inokron-doo/OA-HWcomponents/docs/SFS_Node_Hardware_Documentation_v0.1.docx

# SFS LoRa Sensor Network Node — Open Hardware Documentation

## 1. Hardware Identification

Hardware Title: SFS LoRa Sensor Network Node
Short Description: Open-source dual-role IoT node for feed level and microclimate monitoring in livestock barns. Configurable as sensor node or LoRa concentrator via firmware.
Keywords/Tags: feed monitoring, LoRa, IoT, livestock, digital agriculture, open hardware, OpenAgri
Author(s)/Designer(s): Inokron d.o.o. Hardware Team
Organization: Inokron d. o. o.
Contact Email: info@inokron.com
Repository URL: https://github.com/inokron-doo/OA-HWcomponents
Version: v0.1
Release Date: 2026-06-17

## 2. Purpose and Scope

The SFS LoRa Sensor Network Node is designed for continuous, automated monitoring of feed levels in livestock feeding troughs and measurement of ambient microclimate (temperature and humidity) within agricultural barn environments. The hardware provides the sensing infrastructure for the SmartFeed Feed Monitoring System (SFS), developed under the OpenAgri EU project (SIP13 grant).

## 3. System Overview

The SFS sensor network consists of multiple sensor nodes and one concentrator node per installation, arranged in a LoRa star topology. Sensor nodes are mounted above livestock feeding troughs; the concentrator and edge device are typically located in the farm office or other space with internet connection.

The following external system components are required for a complete installation but are outside the scope of this hardware document:

Component | Purpose
Raspberry Pi 4B | Edge processing device — runs Node-RED data pipeline and local data storage
USB-to-TTL serial adapter (CH340) | Connects concentrator UART output to Raspberry Pi
Huawei E8372 GSM modem | SMS alert delivery, independent of internet connectivity
Network switch and SIM card | Farm network connectivity and remote telemetry
Optional local display | Local operator dashboard (e.g. tablet or Raspberry Pi Touch Display)

## 4. System Architecture

Star topology: one concentrator, multiple sensor nodes per installation.

A single PCB design serves both roles. The hardware is identical for sensor nodes and concentrator nodes; the role is determined solely by the firmware loaded onto the device. This simplifies manufacturing, spares, and field replacement.

Sensor node: samples up to four UART distance sensors and one temperature/humidity sensor, applies on-device filtering, and transmits readings to the concentrator over LoRa.

Concentrator node: receives and validates LoRa packets from all sensor nodes and outputs decoded readings as an ASCII serial stream to the edge device via UART.

Data flow: distance sensors + climate sensor → sensor node → LoRa → concentrator → edge device (UART serial)

Because the hardware is role-agnostic, alternative topologies are achievable through firmware changes alone — for example, deploying multiple concentrators as relay bridges to extend range across a large farm, or introducing a mesh configuration for higher node density. No hardware modifications are required.

## 5. Functional Requirements

Sensor node: Measure feed level via up to four UART distance sensors; measure ambient temperature and humidity; apply initial filtering on-device; transmit readings over LoRa; auto-detect connected sensors; indicate operating status via onboard LEDs.

Concentrator node: Receive and CRC-validate LoRa packets from sensor nodes; output decoded readings as an ASCII serial stream over UART to the edge device; indicate operating status via onboard LEDs.

## 6. Non-Functional Requirements

Environmental: PCB operating temperature: −40°C to +80°C; installed system operating temperature subject to connected sensor specifications (SEN0648 operating range: -10 to +60). Not formally IP rated; enclosure design provides physical dust and splash resistance

Electrical: Mains input: 100–240V AC via HLK-5M05 module; PCB input: 5V DC.

Regulatory: LoRa 868 MHz operation subject to EU regulations.

System: Maximum sensor nodes per concentrator: 32; expected lifetime: >5 years.

## 7. Electronics Design

Schematics description: Schematics designed in Altium Designer (editable source files planned for release at the end of June 2026)
PCB layout description: Two-layer FR4 PCB, manufactured by JLCPCB. Gerber fabrication files are provided in the repository.
Main components: STM32F051K8T7 MCU, LR02 LoRa module, Sensirion SHT85 temperature and humidity sensor.
Electrical characteristics: PCB input 5V DC, 3.3V logic; mains (100–240V AC) handled by the self-contained HLK-5M05 module.

## 8. Mechanical Design

CAD files description:
Materials:
Dimensions and tolerances:
Enclosure design:

## 9. Bill of Materials (BOM)

The main components are:

STM32F051K8T7 MCU – 1 pc;

LR02 LoRa module (868 MHz) – 1 pc;

SHT85 temperature and humidity sensor – 1 pc (DHT22 supported as lower-cost alternative);

SEN0524 / SEN0648 distance sensors – up to 4 per node;

The full Bill of Materials (CSV) is provided in the project repository (electronics/bom/BOM_SFS_Node_v0.1.csv), with manufacturer part numbers, packages, quantities and supplier references (Farnell part numbers).

## 10. Firmware/Software (If Applicable)

Two firmware variants are provided for the same PCB hardware, determining the node’s role in the network:

• Sensor node firmware

• Concentrator node firmware

Both firmware variants are open-source. Full details (repository URLs, toolchain, build instructions, and communication protocol specification) are provided in the separate Open Software documentations.

## 11. Manufacturing and Fabrication

PCB fabricated using standard FR-4;
Gerber files provided;
Enclosure produced via FDM 3D printing.

## 12. Assembly Instructions

PCB: Solder all SMD components, then through-hole components (terminal blocks, pin headers, reset button).

Node enclosure: Mount HLK-5M05 power module, PCB and other components inside the housing. Connect PCB via terminal blocks. Route sensor cables through the enclosure openings. Connect one sensor directly into the integrated sensor slot on the enclosure.

Installation: Both the node enclosure and the additional sensor mounts clamp onto standard construction pipe using a screw-tightened clamp. Slide onto the pipe, aim the sensor vertically downward into the trough, then tighten the screw. The mount can be rotated around the pipe before tightening to fine-tune the sensor angle. Mount approximately 1.5–2m above the trough floor, with additional sensor mounts spaced at least 0.5m apart along the trough.

## 13. Calibration and Testing

Distance sensors configured to 115200 baud via serial command before installation. Empty and full trough heights set per sensor in the edge device configuration interface. Functional test via serial console on the concentrator output; LoRa connectivity verified by confirming all node IDs appear in the serial stream.

## 14. Performance Specifications

Distance sensing (SEN0648): sensor accuracy ±3cm per reading (datasheet); system-level accuracy expected better due to multi-second aggregation, filtering and multi-sensor deployment; refresh rate 100Hz; UART interface.

## 15. Safety and Compliance

PCB operates at 5V DC / 3.3V logic; mains voltage (100–240V AC) is handled by the self-contained HLK-5M05 module mounted separately in the enclosure. Components sourced from Farnell are RoHS-compliant; AliExpress-sourced components are unverified. LoRa 868 MHz operation is subject to local laws. CE marking not assessed.

## 16. Licensing and Usage Rights

Chosen open hardware license: CERN OHL-S v2.0;
Attribution required;
Commercial use allowed under share-alike conditions.

## 17. Reproducibility and Validation

Files provided in the v0.1 repository: schematic PDF, Gerber fabrication files, the full BOM (CSV), and the node enclosure STL (mechanical/SFS_Node_Enclosure_v0.1.stl). The editable schematic/PCB source files (Altium project) and the sensor-mount STL are pending and will be added in a later update (source files after June 2026). PCB is reproducible via any standard 2-layer FR4 fabrication service; the enclosure is printable on any FDM printer. Validated through field deployment at Novak farm, Kranj, Slovenia (4 sensor nodes, 1 concentrator) under OpenAgri SIP13.

## 18. Versioning and Changelog

Hardware versions tracked by PCB silkscreen marking and repository tags.

v0.1 (2026-06-17) - initial release; deployed at Novak farm, Kranj, Slovenia.

## 19. Known Limitations

Enclosure is not IP rated; not suitable for direct water exposure. Feed level readings can be noisy in deployments with a low number of sensors per trough location; a minimum of 3 sensors per location is recommended – with sensors not placed too close together. Temperature readings may degrade if the enclosure is exposed to direct sunlight; shaded installation is recommended.

## 20. Citation and Acknowledgements

Citation: Inokron d.o.o. (2026). SFS LoRa Sensor Network Node v0.1. OpenAgri EU project, SIP13. https://github.com/inokron-doo/OA-HWcomponents.

Funding: developed under the OpenAgri project, SIP13 , funded by the European Union.

## 21. Contact and Support

Maintainer name: Inokron d.o.o. Hardware Team
Institution: Inokron d.o.o., Kranj, Slovenia
Support email/Issue tracker: info@inokron.com
