inokron-doo/OA-HWcomponents/mechanical/SFS_Node_Enclosure_v0.1.stl

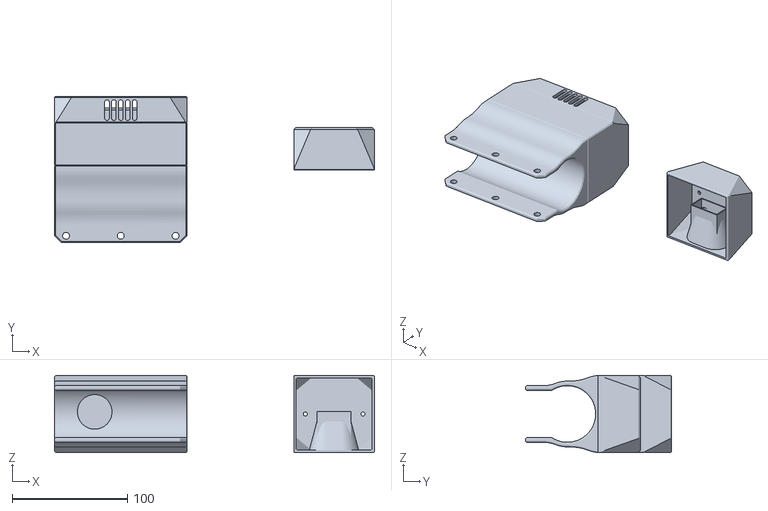
[picture p1: CAD file, 2026-07-06]
mechanical/SFS_Node_Enclosure_v0.1.stl
277.5 x 127.0 x 67.0
