inokron-doo/OA-HWcomponents/electronics/schematic/Lora_SensorNetworkNode_V0_1.1.pdf

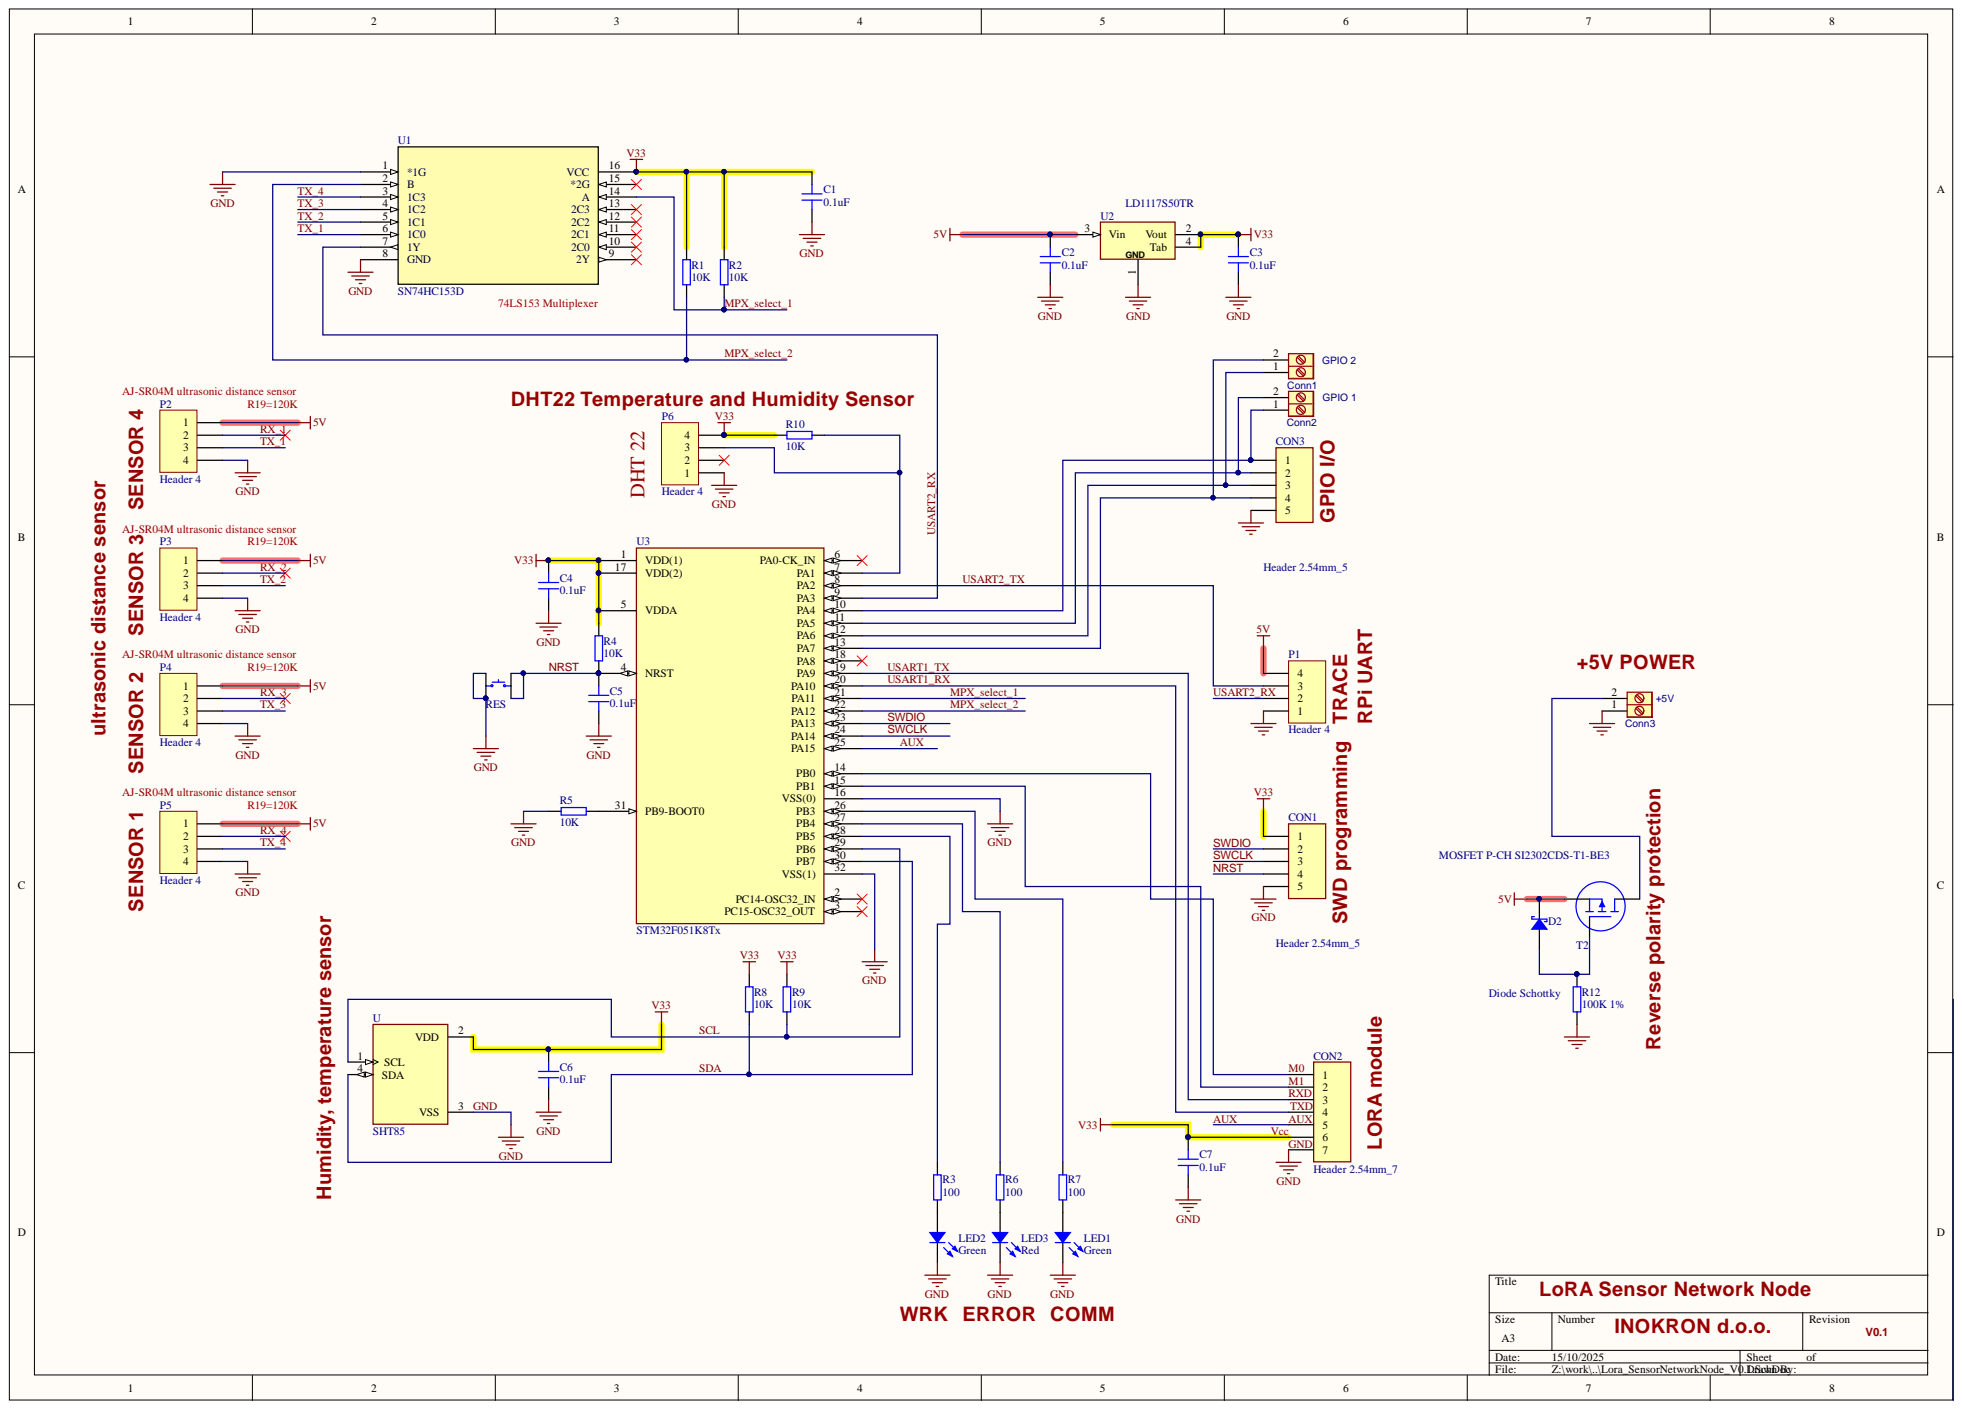
[picture p2: page 1]

MPX_select_2

AJ-SR04M ultrasonic distance sensor

DHT22 Temperature and Humidity Sensor

TXD

AUX

Vcc

Title
LoRA Sensor Network Node

# Board St
