inokron-doo/OA-HWcomponents/(list of files, drawings)

Other design files:
electronics/altium/Lora_SensorNetworkNode_V0.1.PcbDoc
electronics/altium/Lora_SensorNetworkNode_V0.1.PrjPCB
electronics/altium/Lora_SensorNetworkNode_V0.1.SchDoc
