inokron-doo/OA-HWcomponents/(commit log)

2026-06-17 v0.1: repo structure, CERN-OHL-S licence, README, BOM starter, finalized hardware documentation
    [BOM_SFS_Node_v0.1.csv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]
2026-06-17 Add complete BOM (real part numbers + Farnell P/Ns); update status notes
    [BOM_SFS_Node_v0.1.csv]
2026-07-06 Add Altium design sources, node enclosure STL and sensor-mount documentation
    - electronics/altium/: editable schematic and PCB sources (PrjPCB, SchDoc, PcbDoc)
    - mechanical/: node enclosure STL (FDM-printable) and standard-pipe sensor-mount description
    - docs: hardware documentation update
    [Lora_SensorNetworkNode_V0.1.PcbDoc, Lora_SensorNetworkNode_V0.1.PrjPCB, Lora_SensorNetworkNode_V0.1.SchDoc, SFS_Node_Enclosure_v0.1.stl]
2026-10-14 correct lora frequency to 868 mhz in bom and docs
    [BOM_SFS_Node_v0.1.csv]
